ucb-bar/Sirius_bringup/imgs/power_stack.jpeg

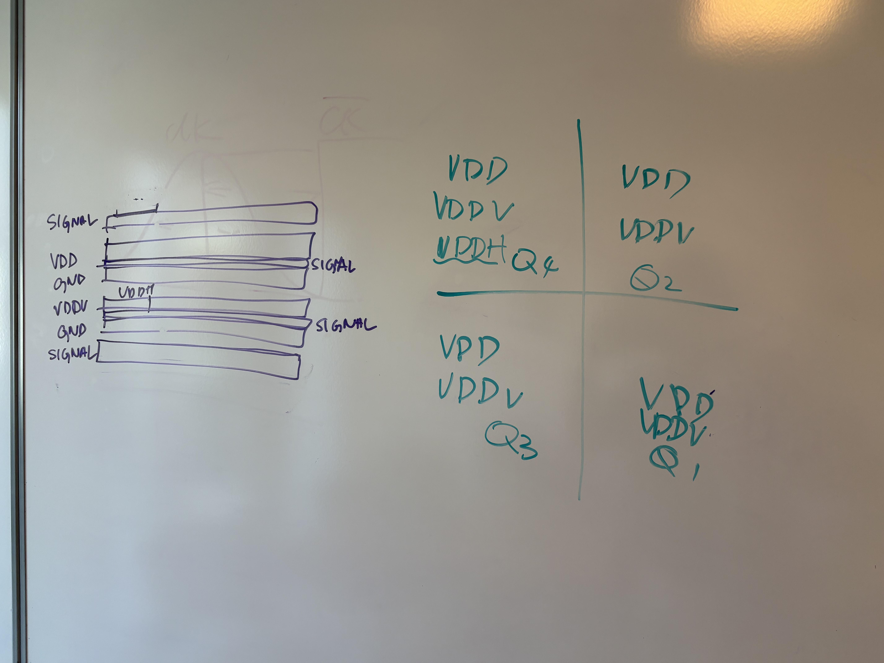
imgs/power_stack.jpeg
