ucb-bar/Sirius_bringup/(list of files, drawings)

Other design files:
cygnus_board/cygnus.PcbDoc
cygnus_board/cygnus_bringup.PrjPcb
cygnus_board/cygnus_pcblib.PcbLib
cygnus_board/cygnus_schlib.SchLib
cygnus_board/cygnus_toplevel.SchDoc
