ucb-bar/Sirius_bringup/(commit log)

2025-01-27 feat: fork from Cygnus and initial pin planning
    [Common Bump Map - ActiveIO and UCIe digital Q2_V2.csv, Common Bump Map - ML_DSP 2024_05_09.csv, Common Bump Map - Redesign of ActiveIO and UCIe digital Q3.csv, Common Bump Map.xlsx, Cygnus pinmap.xlsx, Sirius pinmap.xlsx, cygnus.PcbDoc, cygnus_bringup.PrjPcb]
2025-01-30 chore: updated Sirius pin for UCIe diff clk
    [Sirius pinmap.xlsx]
2025-02-04 chore: schematic preliminary review
    [Common Bump Map - ActiveIO and UCIe digital Q2_V2.csv, Common Bump Map - ML_DSP 2024_05_09.csv, Common Bump Map - Redesign of ActiveIO and UCIe digital Q3.csv, Sirius pinmap.xlsx]
