ucb-bar/Sirius_bringup/imgs/overall_structure.jpeg

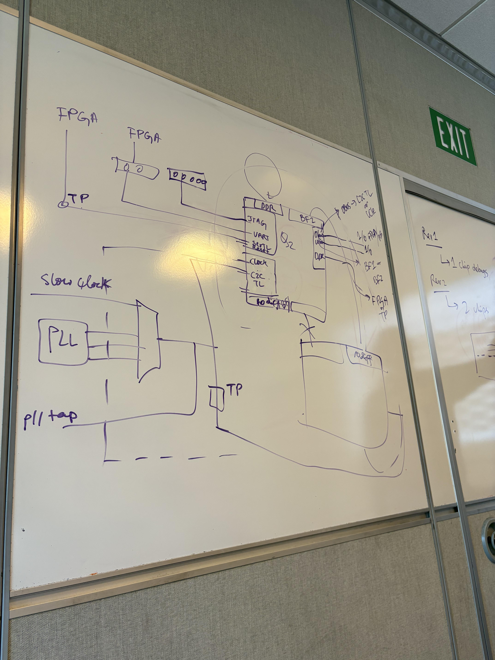
imgs/overall_structure.jpeg
